LEP-PEA-EPUSP/OpenSourcePowerElectronics-HW-FilterBoard-2026/README.md

# OpenSourcePowerElectronics-HW-FilterBoard-2026

This repository contains the manuals, schematic, layout and other files necessary to build and use the LCL filter boards (inductor and capacitor boards).
