LEP-PEA-EPUSP/OpenSourcePowerElectronics-HW-FilterBoard-2026/(list of files, drawings)

Other design files:
Schematics and Layout/Capacitor/PCB1.PcbDoc
Schematics and Layout/Capacitor/PCB capacitor.PcbLib
Schematics and Layout/Capacitor/PCB chave.PcbLib
Schematics and Layout/Capacitor/PCB pad.PcbLib
Schematics and Layout/Capacitor/PCB_Project_1.PrjPcb
Schematics and Layout/Capacitor/Schlib1.SchLib
Schematics and Layout/Capacitor/Sheet1.SchDoc
Schematics and Layout/Inductor/PCB2.PcbDoc
Schematics and Layout/Inductor/PCB chave.PcbLib
Schematics and Layout/Inductor/PCB_Project_2.PrjPcb
Schematics and Layout/Inductor/PcbLib1 indutor.PcbLib
Schematics and Layout/Inductor/Schlib1.SchLib
Schematics and Layout/Inductor/Sheet2.SchDoc
